DeltaLabo/hems/README.md

Heat exposure monitoring and alert system HEMS

============
## DeltaLAB - Instituto Tecnológico de Costa Rica

### Developers

* [Juan J. Rojas Hernández](mailto:juan.rojas@itcr.ac.cr) 

* [Adrián Gutierrez Fuentes](mailto:a.gutierrez@itcr.ac.cr)

* Priscilla Alfaro Ugalde

* Diego Brenes Poveda

* Esteban Cañizales

* Felipe Céspedes

* Angie Cubillo Solano

* Kaleb Granados Acuña

* Joel Gamboa Guillén

* Luis Ledezma Duarte

* Carlos D. Murillo Zamora

* Aymara Marín Corrales

* Felipe Montero Castillo

* Carlos Navarro Mora

* Nicole Prado Morales

* Alejandro Rodríguez

* Bryan Suazo Fonseca

* [Roy David Moya](mailto:roy.d.777@estudiantec.cr)

### What is this repository for? ###

* This repository was created to develop an heat exposure measurement system, to measure heat indexes like Wet Bulb Globe Temperature. These information will be used to detect when a worker is exposed to extreme heat conditions, that can affect their health and development in their work.

This project is in progress.

### Microcontroller info (In progress)

* Model: 
* [Documentation page]()

### Sensors info (In progress)

* [Name of sensor]()

### Data visualization in ThingSpeak (In progress)

* [Click here to open data visualization]()

### How do I get set up? ### (In progress)

* Install Git
* Follow this [instructions]()   (In progress)
* Clone this repo

### Library source code and examples (In progress)

* [Name of library.h]()

### Contribution guidelines ###

* If you want to propose a review or need to modify the code for any reason first clone this [repository](https://github.com/DeltaLabo/hems) in your PC and create a new branch for your changes. Once your changes are complete and fully tested ask the administrator permission to push this new branch into the source.
* If you just want to do local changes instead you can download a zip version of the repository and do all changes locally in your PC.
