DeltaLabo/hems/Esteban/hemspiloto/README.md

# HEMS - Sistema de Evaluación de Estrés Térmico

Sistema para evaluación de estrés térmico laboral basado en normativas internacionales.

## Métodos Implementados
- Índice de Calor (Heat Index)
- TGBH (Temperatura de Globo y Bulbo Húmedo)
- SWreq (Índice de Sudoración Requerida)
- ISC (Índice de Sobrecarga Calórica)

## Instalación Local
```bash
pip install -r requirements.txt
streamlit run app.py
