DeltaLabo/hems/Systems Engineering (v 2.0)/System arquitecture/Arquitectura del sistema - HEMS-SE-03-2026-.pdf

## Arquitectura del sistema

## Proyecto: Heat Exposure Monitoring System [HEMS]

## Identificador del documento: HEMS-SE-03-2026

## Versión 2.0

## Arquitectura del sistema

- En el presente documento, se muestra la arquitectura general del sistema HEMS. Para facilitar la arquitectura, se dividió el sistema en tres subsistemas, según su función:
- Sistema de Medición de Variables Ambientales [AVMS]
- Sistema de Interfaz de usuario y configuración [UICS]
- Sistema de Procesamiento de datos y Almacenamiento [SDPS]

En la siguiente figura, se muestra la arquitectura general del sistema:

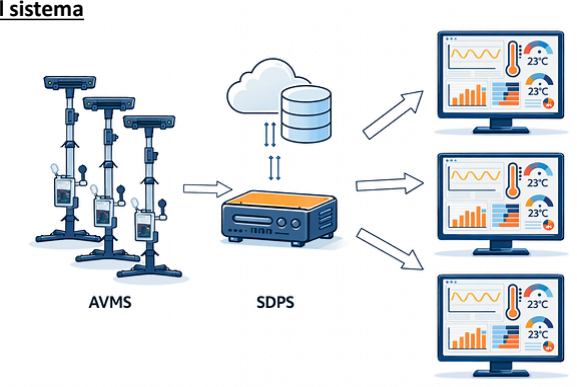
[picture p1: figure]

AVMS: Ambient Variables Measurement System | SDPS: Storage and Data Processing System
UICS : User Interface and Configuration System | UICS

Arquitectura del sistema

Diagrama general
(Nivel I)

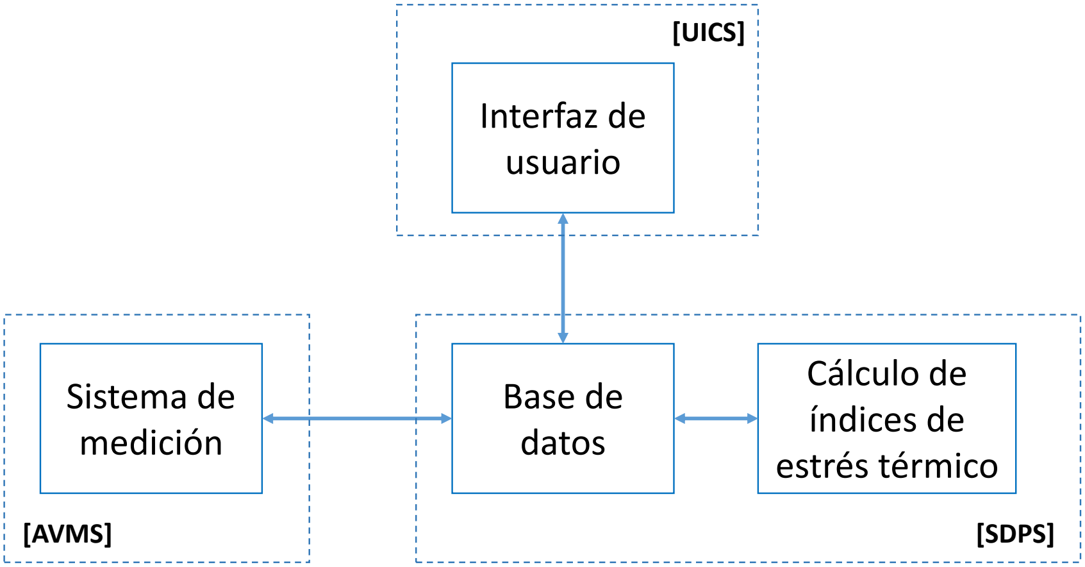
[picture p2: figure]
Base de datos; Cálculo de índices de estrés térmico; Interfaz de usuario; Sistema de medición; [UICS]; [AVMS]; [SDPS]

Sistema de Medición de Variables Ambientales [AVMS] | Sistema de interfaz de usuario y configuración [UICS]
Sistema de Procesamiento de datos y Almacenamiento [SDPS]

## Arquitectura del sistema:

## Sistema de Medición de Variables Ambientales [AVMS]

El sistema de medición de variables ambientales [AVMS] es una plataforma integrada que combina sensores electrónicos, módulos de adquisición de datos y herramientas de procesamiento digital para monitorear en tiempo real las condiciones del entorno.
Su propósito principal es recolectar información confiable sobre parámetros de variables ambientales, para el cálculo de índices de exposición a estrés térmico en trabajadores.

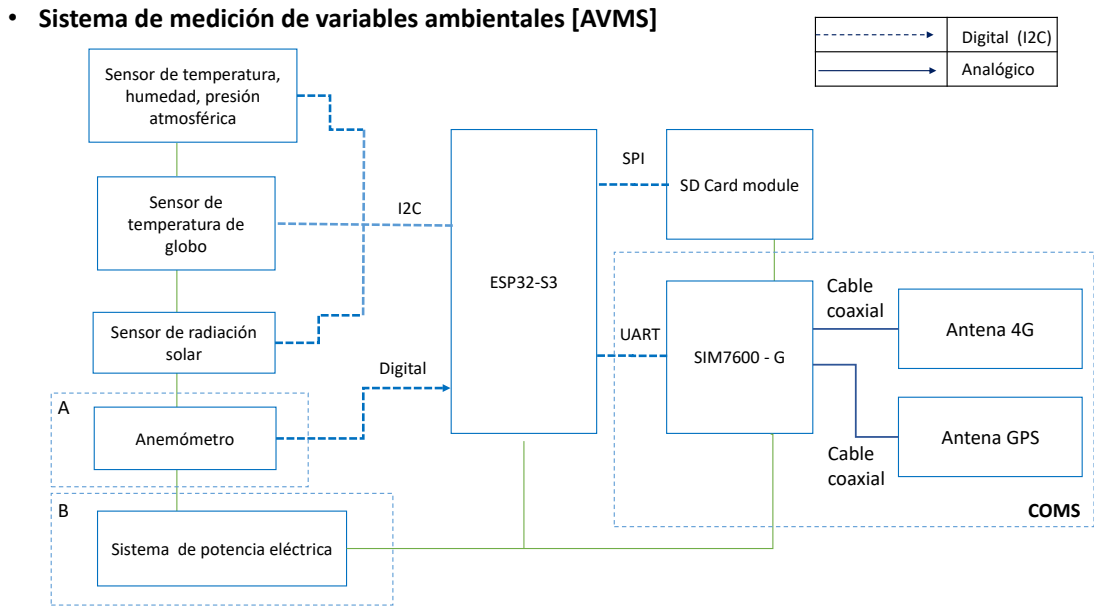
[picture p3: page 6]
ESP32-S3; Anemómetro; solar; SIM7600 - G; Sensor de temperatura de globo; SPI; Digital; UART; Antena GPS; Antena 4G; Cable coaxial; COMS

• Sistema de medición de variables ambientales [AVMS]

Digital (I2C)
Analógico

Sensor de temperatura,
humedad, presión
atmosférica

SD Card module

Sensor de radiación

Sistema de potencia eléctrica

Digital
Analógico
A. Módulo de medición de velocidad del viento

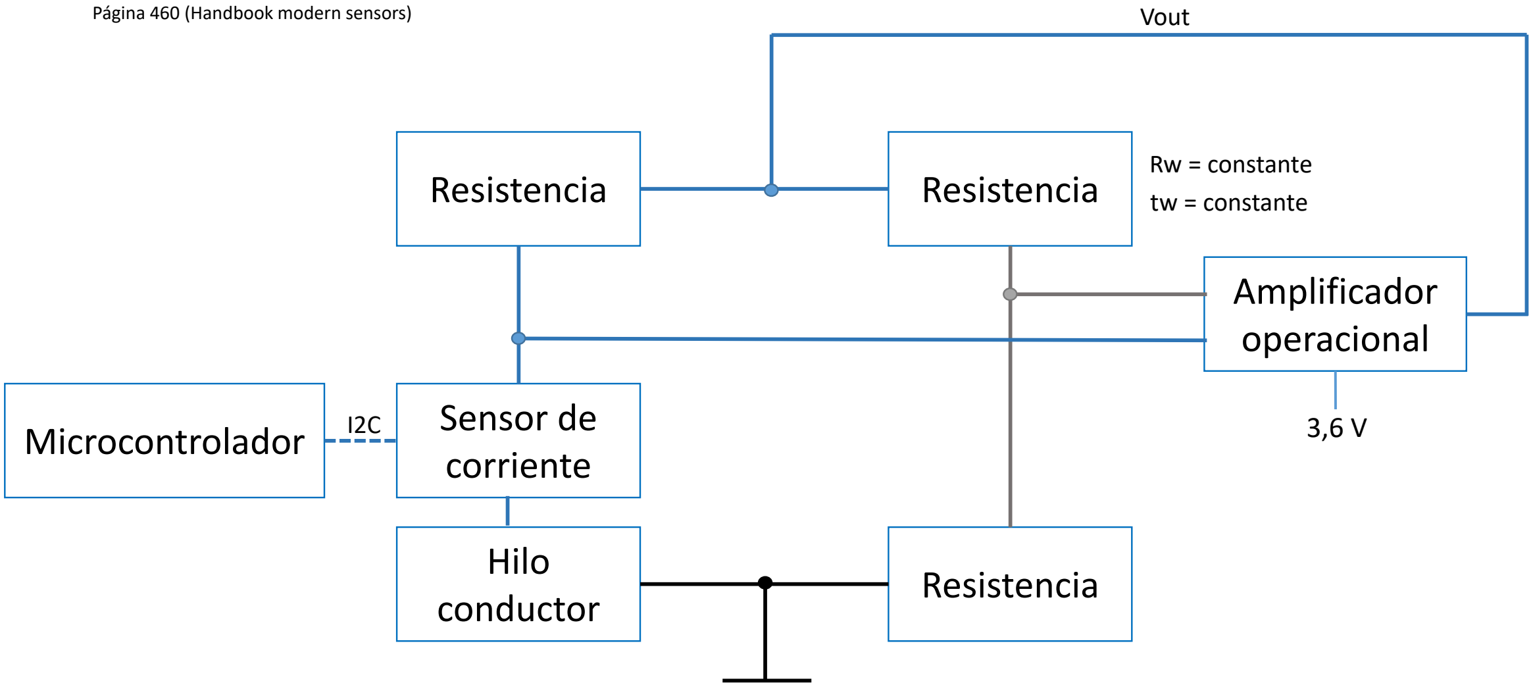
[picture p4: figure]
Resistencia; Sensor de corriente; Amplificador operacional; Vout; Rw = constante tw = constante; Microcontrolador; Hilo conductor; Página 460 (Handbook modern sensors)

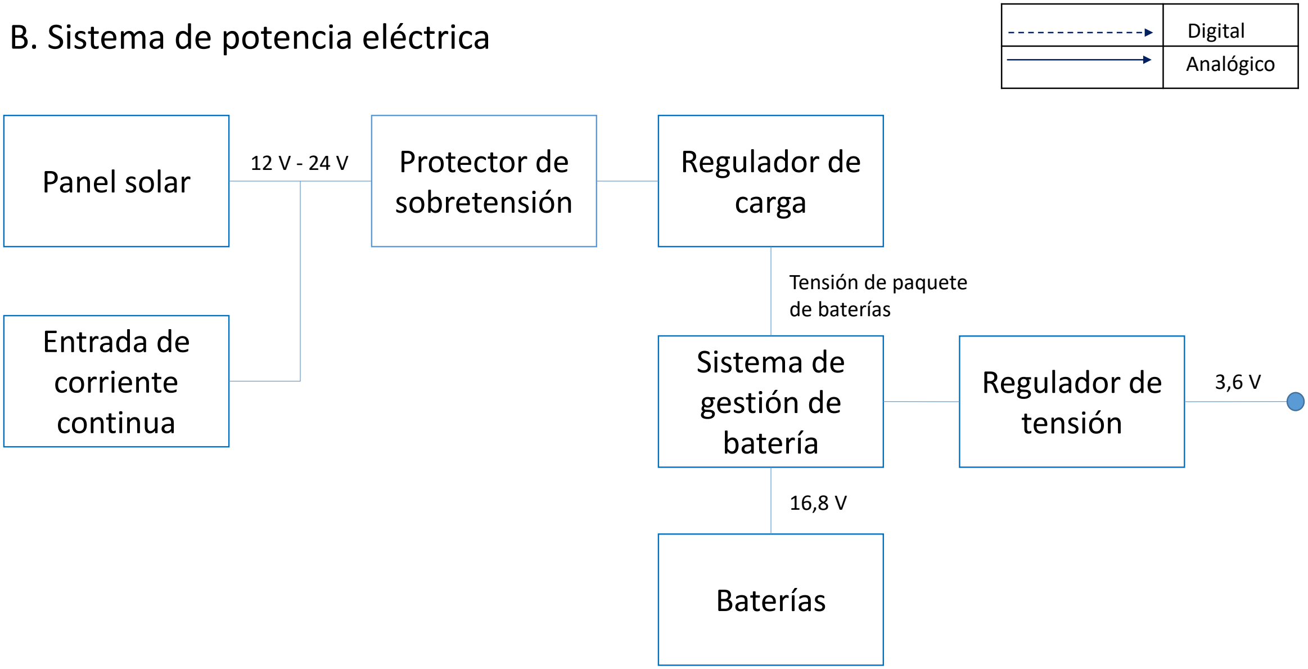
[picture p5: figure]
Panel solar; Digital Analógico; B. Sistema de potencia eléctrica; Baterías; Sistema de gestión de batería; Regulador de carga; Regulador de tensión; Tensión de paquete de baterías; Entrada de corriente continua; Protector de sobretensión

## Arquitectura del sistema:

## Sistema de Procesamiento de datos y Almacenamiento [SDPS]

El sistema de Procesamiento y Almacenamiento de datos [SDPS], está diseñado para capturar, organizar y analizar variables ambientales críticas que influyen en el confort térmico y en la evaluación del riesgo de estrés térmico en personas expuestas a condiciones ambientales exigentes.

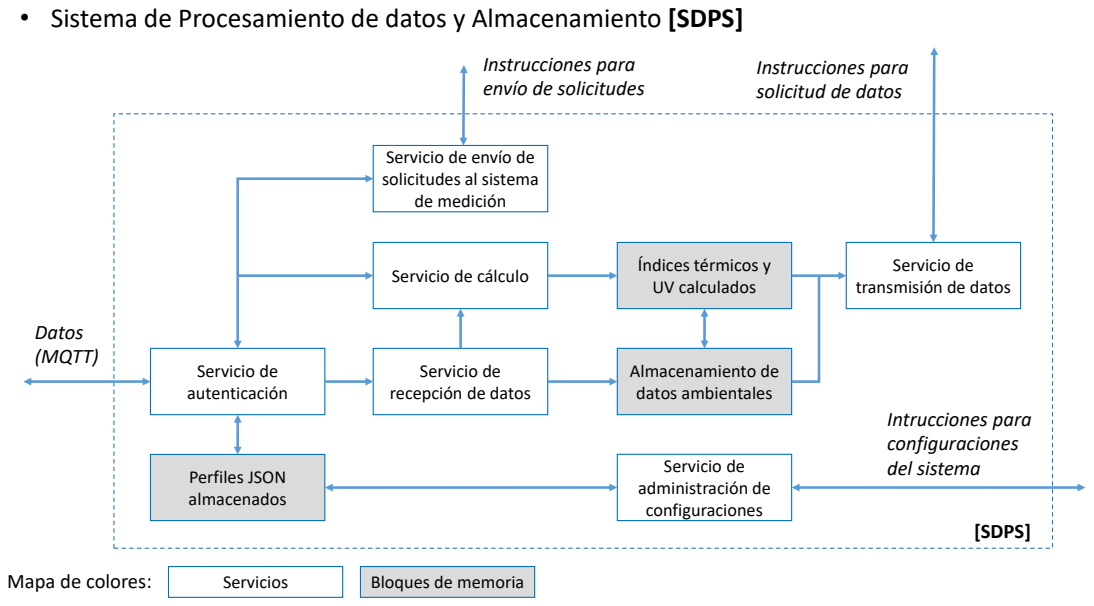
[picture p6: page 10]
Servicio de autenticación; Perfiles JSON almacenados; Almacenamiento de datos ambientales; Índices térmicos y UV calculados; [SDPS]; Datos (MQTT); Intrucciones para configuraciones; Servicio de; del sistema; administración de configuraciones; Mapa de colores:; Servicios; Bloques de memoria

• Sistema de Procesamiento de datos y Almacenamiento [SDPS]

Instrucciones para
envío de solicitudes

solicitud de datos

Servicio de envío de
solicitudes al sistema
de medición

Servicio de
transmisión de datos

Servicio de cálculo

recepción de datos

## Arquitectura del sistema:

## Sistema de Interfaz de usuario y configuración [UICS]

El sistema de Interfaz de Usuario y Configuración [UICS], constituye la capa de interacción con el usuario, permitiendo transformar los datos ambientales capturados y procesados en información clara, accesible y útil para la toma de decisiones.

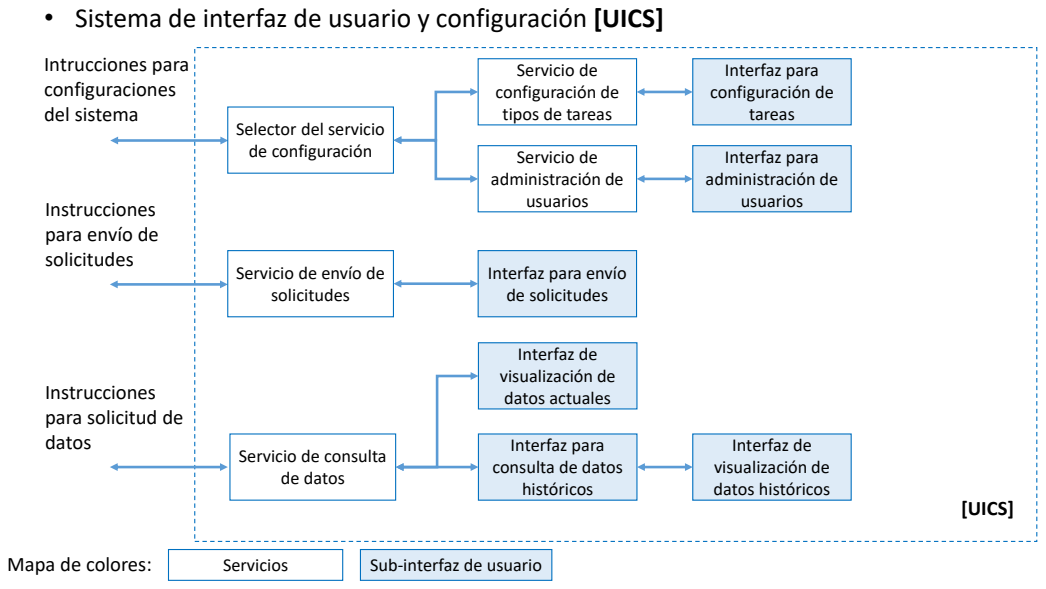
[picture p7: page 12]
Interfaz de visualización de datos actuales; [UICS]; Interfaz de visualización de datos históricos; Servicio de administración de usuarios; Intrucciones para configuraciones del sistema; Interfaz para administración de usuarios; Interfaz para configuración de tareas; Mapa de colores:; Servicios; Sub-interfaz de usuario

• Sistema de interfaz de usuario y configuración [UICS]

Servicio de
configuración de
tipos de tareas

Selector del servicio
de configuración

Instrucciones
para envío de
solicitudes

Servicio de envío de

Interfaz para envío
de solicitudes

para solicitud de
datos

Interfaz para
consulta de datos
históricos

Servicio de consulta
de datos
