DeltaLabo/hems/Code integration/Database/Table structure/Tabla_de_datos.pdf

# Gu´ıa de Usuario: Estructura del Frame de Datos

### March 4, 2026

## 1 Introducci´on

Este documento describe la estructura binaria del frame de datos utilizado para la transmisi´on desde el ESP32 hacia InfluxDB. El frame es compacto (39 bytes), con posiciones fijas y factores de escala aplicados para cada variable.

## 2 Tabla de Estructura del Frame

Campo | Bytes | Offset (desde Start=0xDD)
Escalado
aplicado Ejemplo valor →
Hex
Start byte | 1 | 0 | fijo 0xDD | DD
Timestamp ms | 4 | 1–4 | sin escala | 540000 → 20 3A 08 00
SHT1 Temp (°C) | 2 | 5–6 | ×100 | 24.56 → 98 09
SHT1 RH (%) | 2 | 7–8 | ×100 | 55.20 → 80 15
SHT2 Temp (°C) | 2 | 9–10 | ×100 | 24.70 → 9A 09
SHT2 RH (%) | 2 | 11–12 | ×100 | 54.90 → 72 15
UV A (µW/cm²) | 2 | 13–14 | ×1000 | 0.123 → 7B 00
UV B (µW/cm²) | 2 | 15–16 | ×1000 | 0.045 → 2D 00
UV C (µW/cm²) | 2 | 17–18 | ×1000 | 0.010 → 0A 00
Env Temp (°C) | 2 | 19–20 | ×100 | 25.10 → CE 09
Env Pressure (hPa) | 2 | 21–22 | ×10 | 1013.25 → 8D 27
Env RH (%) | 2 | 23–24 | ×100 | 56.00 → E0 15
INA Vbus (V) | 2 | 25–26 | ×100 | 4.98 → F2 01
INA Current (mA) | 2 | 27–28 | ×10 | 120.5 → 35 04
INA Power (mW) | 2 | 29–30 | ×10 | 600.0 → 70 17
Energy (mWh) | 4 | 31–34 | ×100 | 12.34 → D2 04 00 00
Overcurrent flag | 1 | 35 | 0/1 | 00
Sensor OK flags | 2 | 36–37 | bitmask | 31 → 1F 00
Stop byte | 1 | 38 | fijo 0x77 | 77

1

## 3 Decodificaci´on

- Cada campo tiene posici´on fija en el frame.
- Para recuperar el valor original, se divide por el factor de escala.
- Ejemplo: 0x0998 → 2456 → 24.56 °C (porque se guard´o ×100).

2
