DeltaLabo/hems/Systems Engineering (v 2.0)/Requirements/requerimientos_versiones.md

Versión: 2.0

Fecha: 24/03/2026

Descripción de versión actual:
Requerimientos en formato Latex y PDF

Historial de versiones:

Versión 1.0: Requerimientos del proyecto
