DeltaLabo/hems/Systems Engineering (v 2.0)/System arquitecture/Arquitectura_del_sistema_versiones.md

Versión: 2.0

Fecha: 09/04/2026

Descripción de versión actual:
Arquitectura del sistema, con conexiones en UICS

Historial de versiones:

Versión 1.0: Arquitectura del sistema  (26/03/2026)
