DeltaLabo/hems/Code integration/Esquema de procesamiento/Arquitectura en imagen.jpeg

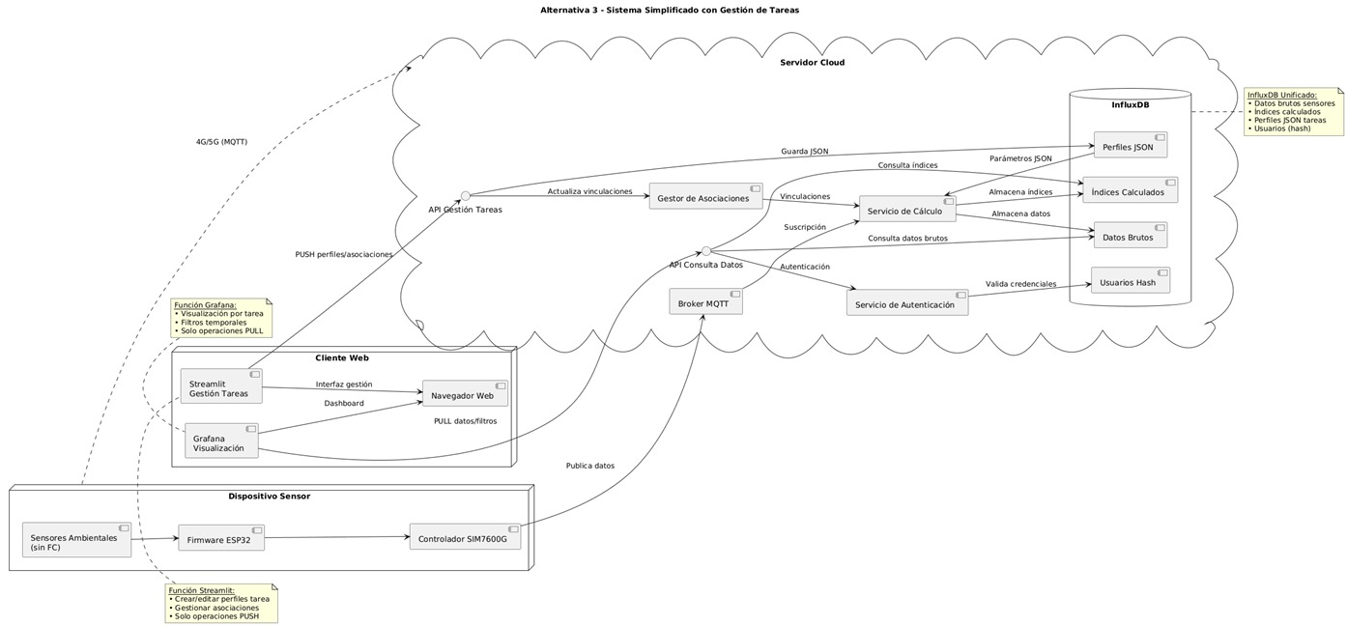
Code integration/Esquema de procesamiento/Arquitectura en imagen.jpeg
