DeltaLabo/hems/Code integration/UV sensor/Read_UV/Sis_vision/1-10.jpg

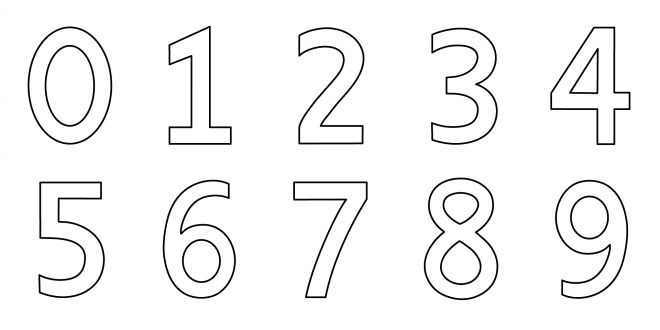
Code integration/UV sensor/Read_UV/Sis_vision/1-10.jpg
