DeltaLabo/hems/Code integration/UV sensor/Read_UV/Sis_vision/IMG_01.jpeg

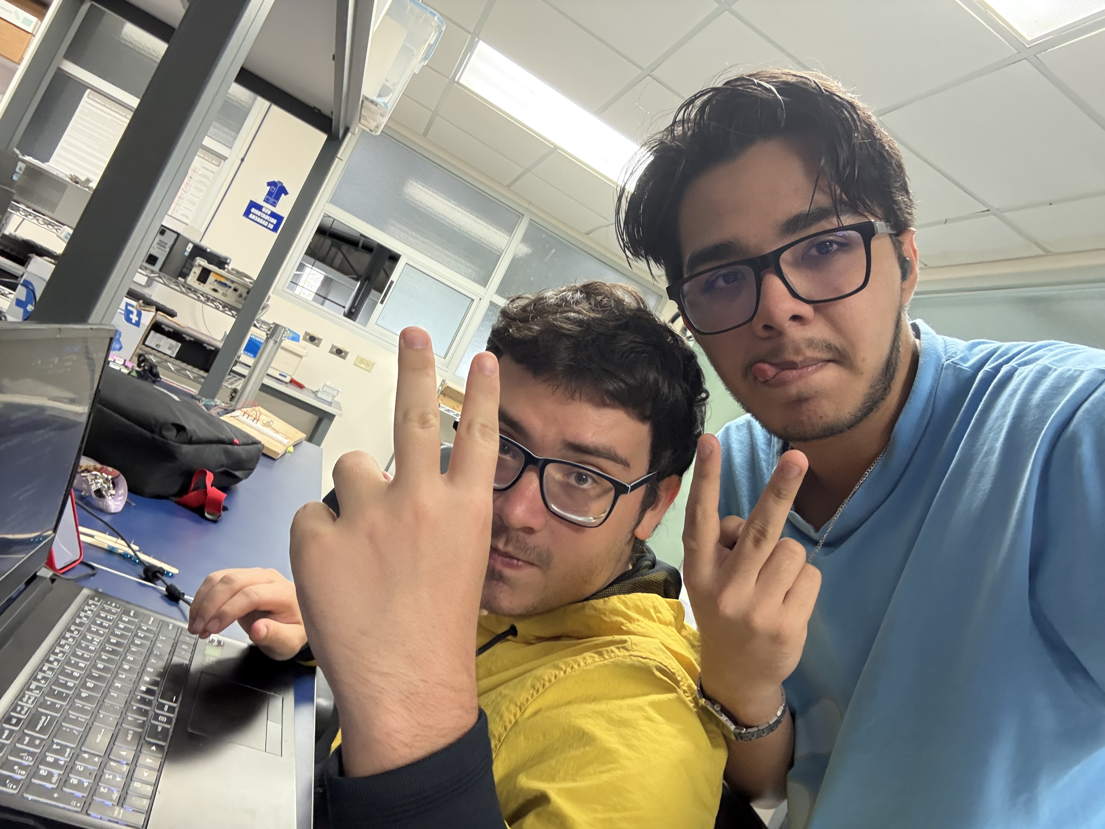
Code integration/UV sensor/Read_UV/Sis_vision/IMG_01.jpeg
