DeltaLabo/hems/Code integration/UV sensor/Read_UV/Sis_vision/placa1.png

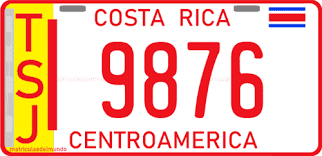
Code integration/UV sensor/Read_UV/Sis_vision/placa1.png
