DeltaLabo/hems/Calibration code/Calibración_INA/Datos_calibración/Calibracion INA 1.xlsx

Sheet: Datos Generales
PLANTILLA PARA CALIBRACIÓN DE MULTÍMETROS DIGITALES
Cálculo de Incertidumbres según GUM / EA-4/02 / INM Colombia / CEM España
DATOS DEL CERTIFICADO
N° Certificado: |  | Fecha de Calibración:
Laboratorio: | Laboratorio Delta | Responsable: | Bryan Suazo/ Felipe Cespedes
DATOS DEL INSTRUMENTO BAJO CALIBRACIÓN (IBC)
Marca: | Arduino | Modelo: | INA219
N° Serie: |  | Código Interno:
Resolución (dígitos): |  | Tipo:
Propietario: |  | Ubicación:
DATOS DEL PATRÓN (CALIBRADOR MULTIFUNCIÓN)
Marca: |  | Modelo:
N° Serie: |  | N° Certificado:
Fecha Certificado: |  | Próxima Calibración:
Laboratorio que Calibró:
CONDICIONES AMBIENTALES
Temperatura (°C): |  | Humedad Relativa (%):
Rango Temp. Permitido: | 18 - 28 | Rango HR Permitido: | ≤ 70
INSTRUCCIONES DE USO
1. Complete los datos generales en esta hoja (celdas amarillas).
2. Vaya a cada hoja de magnitud según necesite calibrar:
• Tensión DC, Tensión AC, Corriente DC, Corriente AC
• Resistencia, Capacitancia, Frecuencia
3. Ingrese los valores del patrón y las 5 lecturas del IBC en las celdas amarillas.
4. Las incertidumbres se calcularán automáticamente.
5. Use la hoja 'Welch-Satterthwaite' para calcular el factor k exacto si tiene pocos grados de libertad.
6. Consulte la hoja 'Resumen Certificado' para el informe final.
NOTA SOBRE WELCH-SATTERTHWAITE
La hoja 'Welch-Satterthwaite' permite calcular los grados efectivos de libertad (νeff)
para determinar el factor de cobertura k correcto según la distribución t de Student.
Esto es especialmente importante cuando el número de repeticiones es bajo (< 10)
o cuando una componente de incertidumbre domina sobre las demás.

Sheet: Tensión DC
CALIBRACIÓN EN TENSIÓN CONTINUA (DC)
PARÁMETROS DEL PATRÓN
Especificación del fabricante (ppm de lectura): |  | 22
Especificación del fabricante (µV offset): |  | 39
Incertidumbre certificado patrón U (del certificado): |  | 3.3e-05 | V
Factor de cobertura k del certificado: |  | 2
TABLA DE MEDICIONES Y CÁLCULO DE INCERTIDUMBRES INA 3
Rango | Valor Patrón | Unidad | Lect. 1 | Lect. 2 | Lect. 3 | Lect. 4 | Lect. 5 | Promedio | Resolución | Error (E) | u(rep) | u(res) | u(cert) | u(espec) | u_c | k | U
 | (Vs) |  | (Vx1) | (Vx2) | (Vx3) | (Vx4) | (Vx5) | (V̄x) | (dig) | (V̄x - Vs) | Tipo A | Tipo B | Tipo B | Tipo B | Comb. |  | Expand.
2.8 | 2.882 | V | 2.852 | 2.853 | 2.852 | 2.852 | 2.852 | 2.852200 | 0.001 | -0.029800 | 0.0002 | 0.0002886751346 | 1.65e-05 | 5.912297697e-05 | 0.0003565124258 | 2 | 0.0007130248516
3.3 | 3.32 | V | 3.358 | 3.358 | 3.357 | 3.357 | 3.358 | 3.357600 | 0.001 | 0.037600 | 0.0002449489743 | 0.0002886751346 | 1.65e-05 | 6.468632416e-05 | 0.0003844345248 | 2 | 0.0007688690496
3.7 | 3.718 | V | 3.761 | 3.762 | 3.762 | 3.761 | 3.761 | 3.761400 | 0.01 | 0.043400 | 0.0002449489743 | 0.002886751346 | 1.65e-05 | 6.974160312e-05 | 0.002898011296 | 2 | 0.005796022593
4.2 | 4.216 | V | 4.267 | 4.266 | 4.267 | 4.267 | 4.267 | 4.266800 | 0.1 | 0.050800 | 0.0002 | 0.02886751346 | 1.65e-05 | 7.606705267e-05 | 0.0288683112 | 2 | 0.05773662241
5 | 5.005 | V | 5.066 | 5.066 | 5.066 | 5.068 | 5.067 | 5.066600 | 1 | 0.061600 | 0.0004 | 0.2886751346 | 1.65e-05 | 8.608869864e-05 | 0.288675425 | 2 | 0.5773508501
 |  |  |  |  |  |  |  |  |  |  | 0 | 0 | 1.65e-05 | 0
 |  |  |  |  |  |  |  |  |  |  | 0 | 0 | 1.65e-05 | 0
 |  |  |  |  |  |  |  |  |  |  | 0 | 0 | 1.65e-05 | 0
 |  |  |  |  |  |  |  |  |  |  | 0 | 0 | 1.65e-05 | 0
 |  |  |  |  |  |  |  |  |  |  | 0 | 0 | 1.65e-05 | 0
LEYENDA Y FÓRMULAS UTILIZADAS
u(rep) - Incertidumbre por repetibilidad (Tipo A): |  |  | u(V̄x) = s(Vx) / √n
u(res) - Incertidumbre por resolución (Tipo B): |  |  | u(δVx) = resolución / (2·√3)
u(cert) - Incertidumbre del certificado del patrón: |  |  | u(Vs) = U_certificado / k
u(espec) - Incertidumbre por especificaciones del patrón: |  |  | u(δVs) = (ppm·|Vs| + offset) / √3
u_c - Incertidumbre combinada: |  |  | uc = √(u_rep² + u_res² + u_cert² + u_espec²)
U - Incertidumbre expandida: |  |  | U = k · uc (k=2 para 95.45%)
NOTA: Las celdas en amarillo son de entrada. Ingrese los valores del patrón, las 5 lecturas del IBC y la resolución.
CÁLCULO AVANZADO DEL FACTOR k (OPCIONAL)
Para un cálculo más preciso del factor k usando la fórmula de Welch-Satterthwaite:
Grados de libertad para incertidumbres Tipo B (asumiendo 5% de inseguridad): |  |  |  | 200
Número de repeticiones (n): |  |  |  | 5
Grados de libertad Tipo A (n-1): |  |  |  | 4
Nota: Si una fuente de incertidumbre rectangular es dominante (> 50% de u_c²),
usar k ≈ 1.65 para 95% de probabilidad de cobertura en lugar de k=2.

Sheet: Tensión AC
CALIBRACIÓN EN TENSIÓN ALTERNA (AC)
PARÁMETROS DEL PATRÓN
Especificación del fabricante (ppm de lectura): |  | 40
Especificación del fabricante (µV offset): |  | 100
Incertidumbre certificado patrón U: |  | 0.00012 | V
Factor de cobertura k del certificado: |  | 2
TABLA DE MEDICIONES Y CÁLCULO DE INCERTIDUMBRES
Rango | Valor Patrón | Frecuencia | Unidad | Lect. 1 | Lect. 2 | Lect. 3 | Lect. 4 | Lect. 5 | Promedio | Resolución | Error (E) | u(rep) | u(res) | u(cert) | u(espec) | u_c | k | U
 | (Vs) | (Hz) |  | (Vx1) | (Vx2) | (Vx3) | (Vx4) | (Vx5) | (V̄x) | (dig) | (V̄x - Vs) | Tipo A | Tipo B | Tipo B | Tipo B | Comb. |  | Expand.
 |  |  | V |  |  |  |  |  |  | 0.001 |  | 0 | 0.0002886751346 | 6e-05 | 0
 |  |  | V |  |  |  |  |  |  | 0.001 |  | 0 | 0.0002886751346 | 6e-05 | 0
 |  |  | V |  |  |  |  |  |  | 0.001 |  | 0 | 0.0002886751346 | 6e-05 | 0
 |  |  | V |  |  |  |  |  |  | 0.001 |  | 0 | 0.0002886751346 | 6e-05 | 0
 |  |  |  |  |  |  |  |  |  |  |  | 0 | 0 | 6e-05 | 0
 |  |  |  |  |  |  |  |  |  |  |  | 0 | 0 | 6e-05 | 0
 |  |  |  |  |  |  |  |  |  |  |  | 0 | 0 | 6e-05 | 0
 |  |  |  |  |  |  |  |  |  |  |  | 0 | 0 | 6e-05 | 0
 |  |  |  |  |  |  |  |  |  |  |  | 0 | 0 | 6e-05 | 0
 |  |  |  |  |  |  |  |  |  |  |  | 0 | 0 | 6e-05 | 0

Sheet: Corriente DC
CALIBRACIÓN EN CORRIENTE CONTINUA (DC)
PARÁMETROS DEL PATRÓN
Especificación del fabricante (ppm de lectura): |  | 50
Especificación del fabricante (µA offset): |  | 10
Incertidumbre certificado patrón U: |  | 1e-05 | A
Factor de cobertura k del certificado: |  | 2
TABLA DE MEDICIONES Y CÁLCULO DE INCERTIDUMBRES INA3
Rango | Valor Patrón | Unidad | Lect. 1 | Lect. 2 | Lect. 3 | Lect. 4 | Lect. 5 | Promedio | Resolución | Error (E) | u(rep) | u(res) | u(cert) | u(espec) | u_c | k | U
10 mA | 10.46 | mA | 10.13 | 10.2 | 10.32 | 9.65 | 10.31 | 10.122000 | 1e-06 | -0.338000 | 0.123182791 | 2.886751346e-07 | 5e-06 | 0.0003077276935 | 0.1231831755 | 2 | 0.246366351
250 mA | 246.926 | mA | 246.82 | 247.16 | 247.56 | 246.07 | 247.43 | 247.008000 | 1e-05 | 0.082000 | 0.2665595618 | 2.886751346e-06 | 5e-06 | 0.007133913131 | 0.266655007 | 2 | 0.533310014
500 mA | 493.951 | mA | 494.81 | 491.81 | 494.83 | 494.58 | 494.56 | 494.118000 | 0.0001 | 0.167000 | 0.5797188974 | 2.886751346e-05 | 5e-06 | 0.01426491064 | 0.579894377 | 2 | 1.159788754
1,0 A | 989.443 | mA | 996.6 | 996.74 | 996.66 | 996.83 | 996.92 | 996.750000 | 0.001 | 7.307000 | 0.05744562647 | 0.0002886751346 | 5e-06 | 0.02856853262 | 0.06415796454 | 2 | 0.1283159291
2,0 A | 1986.89 | mA | 2053.92 | 2054.26 | 2054.43 | 2054.57 | 2055.11 | 2054.458000 | 0.01 | 67.568000 | 0.1958417729 | 0.002886751346 | 5e-06 | 0.05736234732 | 0.2040901082 | 2 | 0.4081802163
 |  |  |  |  |  |  |  |  |  |  | 0 | 0 | 5e-06 | 0
 |  |  |  |  |  |  |  |  |  |  | 0 | 0 | 5e-06 | 0
 |  |  |  |  |  |  |  |  |  |  | 0 | 0 | 5e-06 | 0
 |  |  |  |  |  |  |  |  |  |  | 0 | 0 | 5e-06 | 0
 |  |  |  |  |  |  |  |  |  |  | 0 | 0 | 5e-06 | 0

Sheet: Corriente AC
CALIBRACIÓN EN CORRIENTE ALTERNA (AC)
PARÁMETROS DEL PATRÓN
Especificación del fabricante (ppm de lectura): |  | 100
Especificación del fabricante (µA offset): |  | 50
Incertidumbre certificado patrón U: |  | 5e-05 | A
Factor de cobertura k del certificado: |  | 2
TABLA DE MEDICIONES Y CÁLCULO DE INCERTIDUMBRES
Rango | Valor Patrón | Frecuencia | Unidad | Lect. 1 | Lect. 2 | Lect. 3 | Lect. 4 | Lect. 5 | Promedio | Resolución | Error (E) | u(rep) | u(res) | u(cert) | u(espec) | u_c | k | U
500 mA | 0.5 | 60 | A |  |  |  |  |  |  | 0.001 |  | 0 | 0.0002886751346 | 2.5e-05 | 5.773502692e-05
500 mA | 0.5 | 1000 | A |  |  |  |  |  |  | 0.001 |  | 0 | 0.0002886751346 | 2.5e-05 | 5.773502692e-05
 |  |  |  |  |  |  |  |  |  |  |  | 0 | 0 | 2.5e-05 | 0
 |  |  |  |  |  |  |  |  |  |  |  | 0 | 0 | 2.5e-05 | 0
 |  |  |  |  |  |  |  |  |  |  |  | 0 | 0 | 2.5e-05 | 0
 |  |  |  |  |  |  |  |  |  |  |  | 0 | 0 | 2.5e-05 | 0
 |  |  |  |  |  |  |  |  |  |  |  | 0 | 0 | 2.5e-05 | 0
 |  |  |  |  |  |  |  |  |  |  |  | 0 | 0 | 2.5e-05 | 0
 |  |  |  |  |  |  |  |  |  |  |  | 0 | 0 | 2.5e-05 | 0
 |  |  |  |  |  |  |  |  |  |  |  | 0 | 0 | 2.5e-05 | 0

Sheet: Resistencia
CALIBRACIÓN EN RESISTENCIA (Ω)
PARÁMETROS DEL PATRÓN
Especificación del fabricante (ppm de lectura): |  | 30
Especificación del fabricante (mΩ offset): |  | 5
Incertidumbre certificado patrón U: |  | 0.001 | Ω
Factor de cobertura k del certificado: |  | 2
TABLA DE MEDICIONES Y CÁLCULO DE INCERTIDUMBRES
Rango | Valor Patrón | Unidad | Lect. 1 | Lect. 2 | Lect. 3 | Lect. 4 | Lect. 5 | Promedio | Resolución | Error (E) | u(rep) | u(res) | u(cert) | u(espec) | u_c | k | U
500 Ω | 500 | Ω |  |  |  |  |  |  | 0.1 |  | 0 | 0.02886751346 | 0.0005 | 0.01154700538
5 kΩ | 5000 | Ω |  |  |  |  |  |  | 1 |  | 0 | 0.2886751346 | 0.0005 | 0.08948929172
50 kΩ | 50000 | Ω |  |  |  |  |  |  | 10 |  | 0 | 2.886751346 | 0.0005 | 0.8689121551
500 kΩ | 500000 | Ω |  |  |  |  |  |  | 100 |  | 0 | 28.86751346 | 0.0005 | 8.663140789
5 MΩ | 5000000 | Ω |  |  |  |  |  |  | 1000 |  | 0 | 288.6751346 | 0.0005 | 86.60542713
 |  |  |  |  |  |  |  |  |  |  | 0 | 0 | 0.0005 | 0
 |  |  |  |  |  |  |  |  |  |  | 0 | 0 | 0.0005 | 0
 |  |  |  |  |  |  |  |  |  |  | 0 | 0 | 0.0005 | 0
 |  |  |  |  |  |  |  |  |  |  | 0 | 0 | 0.0005 | 0
 |  |  |  |  |  |  |  |  |  |  | 0 | 0 | 0.0005 | 0

Sheet: Capacitancia
CALIBRACIÓN EN CAPACITANCIA (F)
PARÁMETROS DEL PATRÓN
Especificación del fabricante (ppm de lectura): |  | 100
Especificación del fabricante (pF offset): |  | 0.5
Incertidumbre certificado patrón U: |  | 1e-05 | F
Factor de cobertura k del certificado: |  | 2
TABLA DE MEDICIONES Y CÁLCULO DE INCERTIDUMBRES
Rango | Valor Patrón | Unidad | Lect. 1 | Lect. 2 | Lect. 3 | Lect. 4 | Lect. 5 | Promedio | Resolución | Error (E) | u(rep) | u(res) | u(cert) | u(espec) | u_c | k | U
 | (Cs) |  | (Cx1) | (Cx2) | (Cx3) | (Cx4) | (Cx5) | (C̄x) | (dig) | (C̄x - Cs) | Tipo A | Tipo B | Tipo B | Tipo B | Comb. |  | Expand.
1 nF | 1e-09 | F |  |  |  |  |  |  | 1e-12 |  | 0 | 2.886751346e-13 | 5e-06 | 3.464101615e-13
10 nF | 1e-08 | F |  |  |  |  |  |  | 1e-11 |  | 0 | 2.886751346e-12 | 5e-06 | 8.660254038e-13
100 nF | 1e-07 | F |  |  |  |  |  |  | 1e-10 |  | 0 | 2.886751346e-11 | 5e-06 | 6.062177826e-12
1 µF | 1e-06 | F |  |  |  |  |  |  | 1e-09 |  | 0 | 2.886751346e-10 | 5e-06 | 5.802370205e-11
10 µF | 1e-05 | F |  |  |  |  |  |  | 1e-08 |  | 0 | 2.886751346e-09 | 5e-06 | 5.776389443e-10
100 µF | 0.0001 | F |  |  |  |  |  |  | 1e-07 |  | 0 | 2.886751346e-08 | 5e-06 | 5.773791367e-09
1000 µF | 0.001 | F |  |  |  |  |  |  | 1e-06 |  | 0 | 2.886751346e-07 | 5e-06 | 5.773531559e-08

Sheet: Frecuencia
CALIBRACIÓN EN FRECUENCIA (Hz)
PARÁMETROS DEL PATRÓN
Especificación del fabricante (ppm de lectura): |  | 5
Especificación del fabricante (Hz offset): |  | 0.01
Incertidumbre certificado patrón U: |  | 0.001 | Hz
Factor de cobertura k del certificado: |  | 2
TABLA DE MEDICIONES Y CÁLCULO DE INCERTIDUMBRES
Rango | Valor Patrón | Unidad | Lect. 1 | Lect. 2 | Lect. 3 | Lect. 4 | Lect. 5 | Promedio | Resolución | Error (E) | u(rep) | u(res) | u(cert) | u(espec) | u_c | k | U
 | (fs) |  | (fx1) | (fx2) | (fx3) | (fx4) | (fx5) | (f̄x) | (dig) | (f̄x - fs) | Tipo A | Tipo B | Tipo B | Tipo B | Comb. |  | Expand.
10 Hz | 10 | Hz |  |  |  |  |  |  | 0.001 |  | 0 | 0.0002886751346 | 0.0005 | 0.005802370205
100 Hz | 100 | Hz |  |  |  |  |  |  | 0.01 |  | 0 | 0.002886751346 | 0.0005 | 0.006062177826
1 kHz | 1000 | Hz |  |  |  |  |  |  | 0.1 |  | 0 | 0.02886751346 | 0.0005 | 0.008660254038
10 kHz | 10000 | Hz |  |  |  |  |  |  | 1 |  | 0 | 0.2886751346 | 0.0005 | 0.03464101615
100 kHz | 100000 | Hz |  |  |  |  |  |  | 10 |  | 0 | 2.886751346 | 0.0005 | 0.2944486373
1 MHz | 1000000 | Hz |  |  |  |  |  |  | 100 |  | 0 | 28.86751346 | 0.0005 | 2.892524849
10 MHz | 10000000 | Hz |  |  |  |  |  |  | 1000 |  | 0 | 288.6751346 | 0.0005 | 28.87328696

Sheet: Welch-Satterthwaite
CÁLCULO DE GRADOS EFECTIVOS DE LIBERTAD - FÓRMULA DE WELCH-SATTERTHWAITE
Para determinar el factor de cobertura k exacto según GUM (ISO/IEC Guide 98-3)
FÓRMULA DE WELCH-SATTERTHWAITE
νeff = uc⁴ / Σ(ui⁴/νi)
Donde:
νeff = Grados efectivos de libertad | uc = Incertidumbre combinada | ui = Incertidumbre componente i | νi = Grados de libertad de componente i
DATOS DE ENTRADA (Ingrese los valores de una medición específica)
Componente | Símbolo | Valor u(xi) | Tipo | ν (g.l.) | u⁴/ν | n (repeticiones): | 5
Repetibilidad | u(rep) |  | A | 4 | 0
Resolución | u(res) |  | B | 200 | 0
Certificado Patrón | u(cert) |  | B | 200 | 0
Especificaciones Patrón | u(espec) |  | B | 200 | 0
Otros (si aplica) | u(otros) |  | B | 200 | 0
RESULTADOS
Suma de u⁴/ν: | 0
Incertidumbre combinada uc: | 0
uc⁴: | 0
Grados efectivos de libertad νeff: | 0.00
νeff redondeado (hacia abajo): | 0
Factor de cobertura k (95.45%): | 2.00
TABLA DE REFERENCIA: Factor t de Student (95.45% de confianza)
ν (g.l.) | t (k) |  | ν (g.l.) | t (k)
1 | 12.71 |  | 25 | 2.06
2 | 4.3 |  | 30 | 2.04
3 | 3.18 |  | 40 | 2.02
4 | 2.78 |  | 50 | 2.01
5 | 2.57 |  | 60 | 2
6 | 2.45 |  | 80 | 1.99
7 | 2.36 |  | 100 | 1.98
8 | 2.31 |  | 200 | 1.97
9 | 2.26 |  | 500 | 1.96
10 | 2.23 |  | 1000 | 1.96
15 | 2.13 |  | ∞ | 1.96
20 | 2.09
EJEMPLO DE USO
1. Copie los valores de incertidumbre de cualquier hoja de medición (columnas L, M, N, O)
2. Pegue cada valor en la columna C (Valor u(xi)) correspondiente
3. Verifique el número de repeticiones en H12
4. El factor k calculado aparecerá en B26
NOTA IMPORTANTE:
- Para incertidumbres Tipo B, se asume ν = 200 (5% de incertidumbre relativa en la estimación)
- Si νeff ≥ 100, se puede usar k = 2 directamente
INTEGRACIÓN CON HOJAS DE MEDICIÓN
Para usar el factor k calculado por Welch-Satterthwaite en las hojas de medición:
1. En la columna Q de la hoja de medición, reemplace el valor fijo '2' por:
='Welch-Satterthwaite'!B26

Sheet: Resumen Certificado
RESUMEN DE RESULTADOS PARA CERTIFICADO DE CALIBRACIÓN
DATOS DEL INSTRUMENTO
N° Certificado: | 0 | Fecha: | 0
Marca IBC: | Arduino | Modelo: | INA219
N° Serie: | 0 | Resolución: | 0
Temperatura (°C): | 0 | Humedad (%): | 0
RESULTADOS - TENSIÓN CONTINUA (DC)
Rango | Valor Patrón | Unidad | Indicación IBC | Error | U (k=2) | Unidad
2.8 | 2.882000 | V | 2.852200 | -0.029800 | 0.0007130248516 | V
3.3 | 3.320000 | V | 3.357600 | 0.037600 | 0.0007688690496 | V
3.7 | 3.718000 | V | 3.761400 | 0.043400 | 0.005796022593 | V
4.2 | 4.216000 | V | 4.266800 | 0.050800 | 0.05773662241 | V
5 | 5.005000 | V | 5.066600 | 0.061600 | 0.5773508501 | V
RESULTADOS - TENSIÓN ALTERNA (AC)
Rango | Valor Patrón | Frecuencia | Unidad | Indicación | Error | U (k=2) | Unidad
 |  |  | V |  |  |  | V
 |  |  | V |  |  |  | V
 |  |  | V |  |  |  | V
 |  |  | V |  |  |  | V
RESULTADOS - CORRIENTE CONTINUA (DC)
Rango | Valor Patrón | Unidad | Indicación IBC | Error | U (k=2) | Unidad
10 mA | 10.460000 | mA | 10.122000 | -0.338000 | 0.246366351 | mA
250 mA | 246.926000 | mA | 247.008000 | 0.082000 | 0.533310014 | mA
500 mA | 493.951000 | mA | 494.118000 | 0.167000 | 1.159788754 | mA
1,0 A | 989.443000 | mA | 996.750000 | 7.307000 | 0.1283159291 | mA
2,0 A | 1986.890000 | mA | 2054.458000 | 67.568000 | 0.4081802163 | mA
RESULTADOS - CORRIENTE ALTERNA (AC)
Rango | Valor Patrón | Frecuencia | Unidad | Indicación | Error | U (k=2) | Unidad
500 mA | 0.5 | 60 | A |  |  |  | A
500 mA | 0.5 | 1000 | A |  |  |  | A
RESULTADOS - RESISTENCIA (Ω)
Rango | Valor Patrón | Unidad | Indicación IBC | Error | U (k=2) | Unidad
500 Ω | 500.00 | Ω |  |  |  | Ω
5 kΩ | 5000.00 | Ω |  |  |  | Ω
50 kΩ | 50000.00 | Ω |  |  |  | Ω
500 kΩ | 500000.00 | Ω |  |  |  | Ω
5 MΩ | 5000000.00 | Ω |  |  |  | Ω
DECLARACIÓN DE INCERTIDUMBRE
La incertidumbre expandida reportada (U) se obtiene multiplicando la incertidumbre típica combinada por el factor de cobertura k=2,
lo que corresponde a una probabilidad de cobertura de aproximadamente 95% para una distribución normal.
Las fuentes de incertidumbre consideradas son:
• Repetibilidad de las lecturas del IBC (Tipo A)
• Resolución del IBC (Tipo B, distribución rectangular)
• Incertidumbre del certificado de calibración del patrón
• Especificaciones del fabricante del patrón (deriva, linealidad, temperatura, etc.)
Basado en: Guía INM Colombia para multímetros digitales 4 5/6 (2022) y Procedimiento EL-001 CEM España (2020).
RESULTADOS - CAPACITANCIA (F)
Rango | Valor Patrón | Unidad | Indicación IBC | Error | U (k=2) | Unidad
1 nF | 1e-09 | F |  |  |  | F
10 nF | 1e-08 | F |  |  |  | F
100 nF | 1e-07 | F |  |  |  | F
1 µF | 1e-06 | F |  |  |  | F
10 µF | 1e-05 | F |  |  |  | F
100 µF | 0.0001 | F |  |  |  | F
1000 µF | 0.001 | F |  |  |  | F
RESULTADOS - FRECUENCIA (Hz)
Rango | Valor Patrón | Unidad | Indicación IBC | Error | U (k=2) | Unidad
10 Hz | 10 | Hz |  |  |  | Hz
100 Hz | 100 | Hz |  |  |  | Hz
1 kHz | 1000 | Hz |  |  |  | Hz
10 kHz | 10000 | Hz |  |  |  | Hz
100 kHz | 100000 | Hz |  |  |  | Hz
1 MHz | 1000000 | Hz |  |  |  | Hz
10 MHz | 10000000 | Hz |  |  |  | Hz
NOTA SOBRE EL FACTOR DE COBERTURA
El factor k=2 se utiliza cuando los grados efectivos de libertad (νeff) son ≥ 100.
Para mediciones con pocos grados de libertad, consulte la hoja 'Welch-Satterthwaite' para calcular el factor k correcto.
Referencia: GUM (ISO/IEC Guide 98-3), EA-4/02, Guía INM Colombia (2022), Procedimiento EL-001 CEM España (2020).
