DeltaLabo/hems/Documents/Latex_Test/A1.tex

\documentclass[12pt]{article}
\usepackage[margin=1in]{geometry}
\usepackage{tabularx}

\begin{document}
\noindent
\begin{tabularx}{\linewidth}{Xr}
\textbf{Delta Lab} & \textbf{Report \#1} \\
\textbf{School of Electromechanical Engineering} & ~ \\
\textbf{Costa Rica Institute of Technology} & \textbf{Onboarding} \\
\end{tabularx}

\noindent\rule[2ex]{\textwidth}{2pt}
\begin{tabularx}{\linewidth}{Xr}
\textbf{Participants:} & \\
Name: & Last name: 
\end{tabularx}

\end{document}
