DeltaLabo/hems/Documents/Latex_Test/A1.pdf

Delta Lab | Report #1
School of Electromechanical Engineering
Costa Rica Institute of Technology | Onboarding
Participants:
Name: | Last name:

1
