DeltaLabo/hems/Entrega Final/Calibracion_temp_hum/ajuste sensores.xlsx

 | Punto 1(A) |  |  |  | Punto 2 (B) |  |  |  |  | Punto 3 ©
 | Medicion 1 | Medicion 2 | Promedio |  | Medicion 1 | Medicion 2 | Promedio |  |  | Medicion 1 | Medicion 2 | Promedio
Patron Globo | 24.7 | 24.8 | 24.75 | Patron Globo | 35.7 | 36.4 | 36.05 |  | Patron Globo | 37 | 35.6 | 36.3
Patron BS | 24.2 | 24.4 | 24.3 | Patron BS | 26.2 | 26.2 | 26.2 |  | Patron BS | 26.2 | 26.1 | 26.15
Patrón HUM | 69.4 | 69.3 | 69.35 | Patrón HUM | 61.4 | 61.3 | 61.35 |  | Patrón HUM | 61.3 | 60.2 | 60.75
SHT-3T01 | 24.06 | 24.06 | 24.06 | SHT-3T01 | 34.37 | 35.63 | 35 |  | SHT-3T01 | 37.35 | 36.42 | 36.885
SHT-3T02 | 25.12 | 24.9 | 25.01 | SHT-3T02 | 29.29 | 29.43 | 29.36 |  | SHT-3T02 | 29.89 | 29.56 | 29.725
BME-T01 | 25.3 | 25.07 | 25.185 | BME-T01 | 28.5 | 29.01 | 28.755 |  | BME-T01 | 30.09 | 29.84 | 29.965
SHT-H01 | 69.65 | 70.43 | 70.04 | SHT-H01 | 56.18 | 55.34 | 55.76 |  | SHT-H01 | 54.96 | 54.73 | 54.845
BME-H01 | 61.09 | 61.64 | 61.365 | BME-H01 | 49.73 | 48.33 | 49.03 |  | BME-H01 | 45.02 | 45.7 | 45.36
 | Globo |  |  | Bulbo seco SHT |  |  |  | Bulbo seco BME |  |  |  | Humedad SHT |  |  | Humedad BME
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
