DeltaLabo/hems/Calibration code/Calibración_INA/Datos_calibración/mediciones INA.xlsx

Sheet: Hoja1
 |  |  |  |  |  |  |  |  |  |  | V Fuente
 | Medicion 1 | Medicion 2 | Medicion 3 | Voltaje Bus (V) |  | Voltaje bus | V Shunt (mV) | Corriente (mA) | Potencia (mW)
Mediciones Multimetro | 3.465 | 3.465 | 3.465 | 3.465 | Mediciones INA | 3.469 | 26 | 266.56 | 914.43 |  | 3.5
 | 3.760 | 3.760 | 3.760 | 3.760 |  | 3.810 | 29.202 | 291.88 | 1103.76 |  | 3.8
 | 4.055 | 4.055 | 4.055 | 4.055 |  | 4.107 | 31.463 | 314.55 | 1282.1 |  | 4.1
 | 4.412 | 4.412 | 4.412 | 4.412 |  | 4.470 | 34.793 | 347.70 | 1541.56 |  | 4.4
 | 4.707 | 4.707 | 4.707 | 4.707 |  | 4.735 | 37.185 | 371.72 | 1745.09 |  | 4.7
 | 4.743 | 4.743 | 4.743 | 4.743 |  | 4.683 | 37.462 | 374.39 | 1736.21 |  | 4.8
 | 4.940 | 4.940 | 4.940 | 4.940 |  | 4.961 | 39.033 | 390.23 | 1918.68 |  | 5
 |  |  |  | y |  | x
 | Medicion 1 | Medicion 2 | Medicion 3 | Corriente (mA) |  | Tension Patrón | Tensión Calibrando | Diferencia |  | pendiente | intercepto | Suma Patrón
 | 269.168 | 269.177 | 269.161 | 269.169 |  | 3.465 | 3.4338102 | 0.031 |  | 1.0158 | -0.09 | 3.496
 | 290.391 | 290.375 | 290.388 | 290.385 |  | 3.760 | 3.780198 | -0.020 |  |  |  | 3.780
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
