DeltaLabo/hems/(threads)

Thread 3 (2025-09-21):

Test vision system for UV sensor calibration

nicolepradom, 2025-09-21:
**Description:**
Test the vision system using the raspberry pi camera to read and save data from the Sper Scientific UV sensor from Prof. Adrián.

**Motivation:**
To have more accurate readings from the Sparkfun UV sensor used in the HEMS project, and collect more data from the Sper Scientific sensor  without having to transcribe it manually.
