DeltaLabo/hems/(commit log)

2025-09-01 subir sistema de visión para medidas
    [sensor_readings.csv]
2025-09-05 Adición de tres codigos mock para simular servidores y un nuevo dashboard que reciba de esos servidores. Tambien se añade un default de un perfil de tarea en un archivo json.
2025-09-08 Actualización de README.md
    Se añade a Luis Ledezma al ReadMe
2025-09-10 Subir codigo de prueba
2025-09-11 adicion de la funcion indice de calor a Funciones
2025-09-11 programa para el input de datos
2025-09-11 mas detalle en el json de data input
2025-10-06 Muchos cambios a streamlit 2, Asilamiento con más conjuntos y en español latino, cambios en funciones
    [Aislamiento.csv]
2025-10-06 se añade una carpeta llamada HEMS app con el acomodo de archivos para el despliegue y modificaciones a la app
    [Aislamiento.csv, CAVS.csv, Metabolismo.csv]
2025-11-12 uv sensor code
2025-11-12 Codigo Provicional
    no sirve, no imprime nada(por el momento)
2026-02-12 Organización de carpetas - 12-02-2026
    [entradas.csv, sensor_readings.csv]
2026-02-17 Actualización de carpetas 17-02-26
    [Aislamiento.csv, CAVS.csv, Metabolismo.csv, Vestimenta.csv]
2026-02-25 Carpeta añadida Calibration code
2026-03-04 Carpeta para tabla de código
2026-03-04 Archivos para base de datos
    Se añaden archivos que faciliten la prueba de base de datos y su procesamiento posterior
2026-03-16 prueba ultravioleta con interrupción
    codigo para prueba ultravioleta
2026-03-19 Actualización para carga de datos de simulación
2026-03-24 Requerimientos - Formato Latex y PDF
    [requerimientos.csv]
2026-03-24 Actualización de ejemplo de decodificación en Python
2026-03-24 Prueba de base de datos (Formato CSV)
    [Database.csv]
2026-04-06 Arquitectura del sistema
    [requerimientos.csv]
2026-04-09 Actualización de documentos de arquitectura del sistema
2026-04-09 Actualización de descripción de arquitectura - 09-04-2026
2026-04-14 Actualización de decodificación 14-04-2026
2026-04-16 Integración de interrupciones - sensor UV
2026-04-20 Actualización de decodificación 20-04-2026
2026-04-20 Reorganización de carpeta de Decodificación
2026-04-20 Presupuesto de Potencia
    [HEMS Presupuesto.xlsx]
2026-04-20 Actaulización de integración 20-04-2026
2026-04-20 Código para pruebas de horno con control
2026-04-22 Add files via upload
    Actualización de los métodos, incluye Fanger para confort térmico
    [Aislamiento.csv, AislamientoFanger.csv, CAVS.csv, Metabolismo.csv, factores_de_correccion_humedad_alta.csv, factores_de_correccion_humedad_media.csv, factores_de_correccion_humedad_sedentaria.csv, factores_de_correccion_trm_alta.csv]
2026-04-27 codigo de control
    codigo de control para el horno
2026-05-06 Ajuste con patron para el INA
    Calibración del INA.
2026-05-07 Actualización de nombre de archivo de lectura
2026-05-12 Modificacion de nombres
2026-05-12 Se incorpora repetibilidad de mediciones
2026-05-12 Actualización de método de lectura de sensor
2026-05-12 Acumulación de variables para envío
2026-05-12 Actualizacion de acumulación para envío
2026-05-15 Actualización de versiones
2026-05-15 Actualización de nombres de variables (versión 2.5)
2026-05-15 Actualización de indicador de versión de firmware
2026-05-15 Actaulización de orden de variables en payload hexadecimal
2026-05-21 update
    Show the data
    [Aislamiento.csv, CAVS.csv, Metabolismo.csv, Vestimenta.csv]
2026-09-24 Add GPS location sending functionality using SIM7600
    Al field 6 se envia la latitud y en el field 7 se envia la longitud, esta en decimales.
    Busca las ubicaciones de Google y sino las encuentra busca la ubicacion de las torres de señal celular.
2026-10-01 AS7331 calibration uptated
2026-10-08 Actualización de código
2026-10-09 Full sensor int - except LCD
